OSCARJU/SingleChipVOC_Board/unnamed (1).jpg

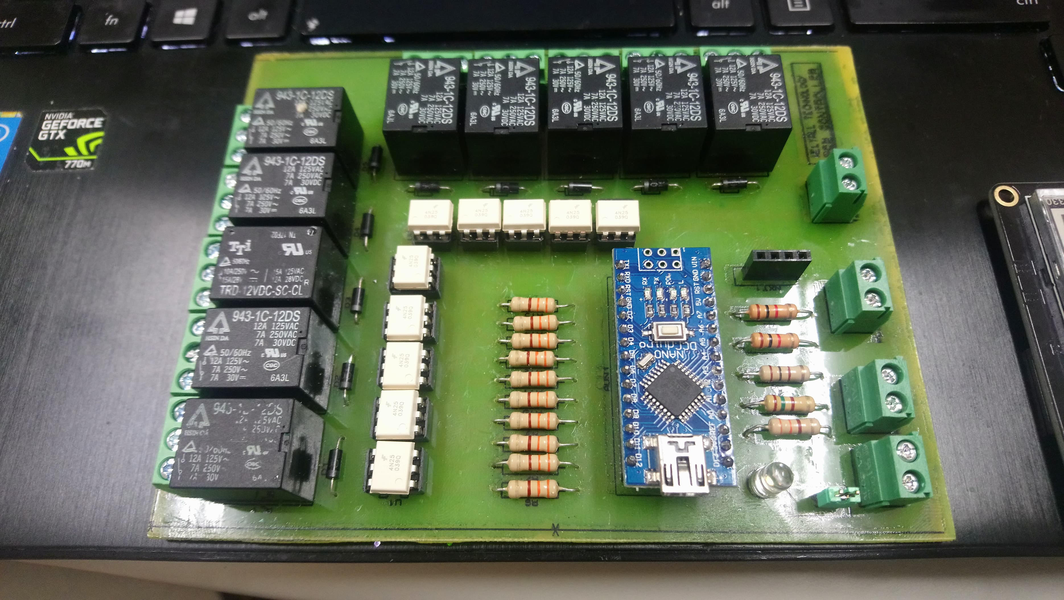
unnamed (1).jpg
